blueshiftPDX/Helium/README.md

Helium
======

Helium supercapacitor-powered portable wireless speaker
