blueshiftPDX/Helium/hardware/helium_final_release_BOM.xls.xlsx

Sheet: main_1-5
BOM | Helium_main_1-6 | 2014-06-24
red | Do not install
yellow | changed part from v1.5
green | addition from v1.5
QTY | Reference | Part number | Manufacturer | Distributor No. | Description | Footprint | DNI? | link | NOTES
1 | U1 | BQ24640RVAR | TI | 296-27258-1-ND | supercapacitor charger IC | VQFN16 |  | http://www.digikey.com/product-detail/en/BQ24640RVAR/296-27258-1-ND/2270340
3 | P3, P4, P5 | B4B-PH-K-S(LF)(SN) | JST | 455-1706-ND | 4pin JST connector | H4_2mm |  | http://www.digikey.com/product-detail/en/B4B-PH-K-S(LF)(SN)/455-1706-ND/926613 | was side entry in 1.5 – now top entry, additional connector at P5. Mount so that slot faces board edge
2 | U5, U6 | MAX9759ETE+ | Maxim | MAX9759ETE+-ND | Mono Class-D Amp | TQFN16 |  | http://www.digikey.com/product-detail/en/MAX9759ETE%2B/MAX9759ETE%2B-ND/1495252
3 | SW3, SW2, P1 | 3-644456-2 | TE Connectivity | A31112-ND | Header open 2 pin .1” | SIL-2 |  | http://www.digikey.com/product-detail/en/3-644456-2/A31112-ND/698344
2 | Q3,Q2 | SIR426DP-T1-GE3 | Vishay | SIR426DP-T1-GE3CT-ND | Mosfet N-CH 40V | PowerPak SO-8 Single |  | http://www.digikey.com/product-detail/en/SIR426DP-T1-GE3/SIR426DP-T1-GE3CT-ND/2442130
0 | K1 | B03B-XASK-1(LF)(SN)(P) | JST | 455-1990-nd | Header shrouded 3 pin 2.5mm | SIL-3 | DNI |  | removed since v1.5
1 | U4 | Murata OKAMI 7805 | Murata | OKI-78SR-5/1.5-W36-C | Okami 7805 replacement TH | SIL-3 |  | http://www.digikey.com/product-detail/en/OKI-78SR-5%2F1.5-W36-C/811-2196-5-ND/2259781
1 | L1 | SRR1280-150M | Bourns Inc. | SRR1280-150MCT-ND | 15uH | SRR1280 inductor |  | http://www.digikey.com/product-detail/en/SRR1280-150M/SRR1280-150MCT-ND/2127431
4 | L2,L3,L4,L5 | SRR1280-330M | Bourns Inc. | SRR1280-330MCT-ND | 33uH | SRR1280 inductor |  | http://www.digikey.com/product-detail/en/SRR1280-330M/SRR1280-330MCT-ND/2127440
1 | U3 | TLV70245DBVT | TI | 296-30480-1-ND | 4.5V LDO | SOT23-5 |  | http://www.digikey.com/product-detail/en/TLV70245DBVT/296-30480-1-ND/3313487
1 | D2 | S10A-TP | Micro Commercial Co. | S10A-TPMSCT-ND | 10A diode | 2 pads .19” spacing |  | http://www.digikey.com/product-detail/en/S10A-TP/S10A-TPMSCT-ND/2041589
1 | F1 | 64900001039 | Littlefuse | WK0011-ND | fuse holder | http://media.digikey.com/pdf/Catalog%20Drawings/Circuit%20Protection/19649series-footprint.jpg |  | http://www.digikey.com/product-detail/en/64900001039/WK0011-ND/245470
1 | D1 | BAT54 | Fairchild Semi | BAT54FSCT-ND | BAT54 schottkey diode | SOT23-3 |  | http://www.digikey.com/product-detail/en/BAT54/BAT54FSCT-ND/458928
1 | R6 | WSL2010R0100FEA18 | Vishay | WSLF-.01CT-ND | .01 ohm sense resistor | SM2010 |  | http://www.digikey.com/product-detail/en/WSL2010R0100FEA18/WSLF-.01CT-ND/713450
3 | C4,C3,C19 | UMK316AB7475KL-T | Taiyo Yuden | 587-2994-1-ND | 4.7uF X7R | SM1206 |  | http://www.digikey.com/product-detail/en/UMK316AB7475KL-T/587-2994-1-ND/2714187
7 | C34,C27,C22,C23,C24,C12,C11 | GMK316BJ106KL-T | Taiyo Yuden | 587-2484-1-ND | 10uF X5R | SM1206 |  | http://www.digikey.com/product-detail/en/GMK316BJ106KL-T/587-2484-1-ND/2230350
1 | R18 | RC1206FR-0710RL | Yageo | 311-10.0FRCT-ND | 10 ohm 1/4W 1% film | SM1206 |  | http://www.digikey.com/product-detail/en/RC1206FR-0710RL/311-10.0FRCT-ND/731429
11 | R21,R19,R20,R29,R22,R24,R27,R13,R9,R7,R11 | RC0603FR-0710KL | Yageo | 311-10.0KHRCT-ND | RES 10.0K OHM 1/10W 1% | SM0603 |  | http://www.digikey.com/product-detail/en/RC0603FR-0710KL/311-10.0KHRCT-ND/729827
7 | C29,C13,C9,C10,C25,C26,C28 | C1608X7R1H104K080AA | TDK | 445-1314-1-ND | 0.1uF X7R | SM0603 |  | http://www.digikey.com/product-detail/en/C1608X7R1H104K080AA/445-1314-1-ND/567687
8 | C16,C14,C18,C21,C17,C1,C2,C15 | GMK107BJ105KA-T | Taiyo Yuden | 587-1437-1-ND | 1uF X7R | SM0603 |  | http://www.digikey.com/product-detail/en/GMK107BJ105KA-T/587-1437-1-ND/1004068
5 | R14,R12,R10,R8,R25 | MCR03ERTF4991 | Rohm Semi | RHM4.99KCFCT-ND | 5k 1% | SM0603 |  | http://www.digikey.com/product-detail/en/MCR03ERTF4991/RHM4.99KCFCT-ND/2796487
6 | R23,R5,R16,R15,R17,R30 | ERJ-3EKF4992V | panasonic | P49.9KHCT-ND | 50k 1% | SM0603 |  | http://www.digikey.com/product-detail/en/ERJ-3EKF4992V/P49.9KHCT-ND/198413
1 | R4 | RC0603FR-07487KL | Yageo | 311-487KHRCT-ND | 487k 1% | SM0603 |  | http://www.digikey.com/product-detail/en/RC0603FR-07487KL/311-487KHRCT-ND/730210 | different value from 1.5
1 | C5 | CL10C220JB8NNNC | Samsung | 1276-1023-1-ND | 22pF ceramic | SM0603 |  | http://www.digikey.com/product-detail/en/CL10C220JB8NNNC/1276-1023-1-ND/3889109
1 | R1 | ERJ-1TYJ2R0U | panasonic | PT2.0XCT-ND | 2 ohm 5% | SM2512 |  | http://www.digikey.com/product-detail/en/ERJ-1TYJ2R0U/PT2.0XCT-ND/365369
1 | J1 | JST_3-PIN_WITH_WIREOUTS | JST | PRT-09915 | 3pin JST connector 2mm | H3_2mm |  | https://www.sparkfun.com/products/9915 | moved slightly north from 1.5
4 | C36,C37,C39,C38 | ECQ-E2333KF | panasonic | EF2333-ND | 0.033µF TH polyester | cap_NP_7.5mm |  | http://www.digikey.com/product-detail/en/ECQ-E2333KF/EF2333-ND/56438
4 | C31,C33,C32,C30 | ECQ-V1154JM | panasonic | P4727-ND | .15uF TH polyester | cap_NP_9mm |  | http://www.digikey.com/product-detail/en/ECQ-V1154JM/P4727-ND/11530
3 | C8,C7,C6 | ECQ-V1H105JL | panasonic | P4675-ND | 1uF TH polyester | cap_NP_9mm |  | http://www.digikey.com/product-detail/en/ECQ-V1H105JL/P4675-ND/144391
2 | C41,C40 | ECQ-E2474KB | panasonic | P10975-ND | .47uF TH polyester | cap_NP_12.5mm |  | http://www.digikey.com/product-detail/en/ECQ-E2474KB/P10975-ND/295882
1 | U2 | BC127 | Bluecreation |  | BC127 Bluetooth module | 51 pin module |  | http://bluecreation.com/product_info.php?products_id=38 | shipping from Blue Creation (UK) (may have arrived 6/24?)
1 | SW1 | MMS42 | Apem Inc. | 679-1858-ND | 4PDT switch | DIL12 (2mm P x 2.5mm W) |  | http://www.digikey.com/product-detail/en/MMS42/679-1858-ND/1799368
4 | R2,R3,R26,R28 | DNP |  |  | extra resistor slots |  | DNI |  | Add 931K resistor at R2 for 15.9V limit; without this VCAP(max) = 23.9V
1 | JP1 | EG1218 | E-Switch | EG1903-ND | SPDT switch | SIL-3 |  | http://www.digikey.com/product-detail/en/EG1218/EG1903-ND/101726
1 | J2 | MOLEX_.1”_2pin | Molex | PRT-09918 | 2 pin molex vertical connector | SIL-2 |  | https://www.sparkfun.com/products/9918 | added since 1.5
1 | W1 | Automotive Jumper | Molex | PRT-09923 | Automotive Jumper 2-wire | SIL-3 |  | https://www.sparkfun.com/products/9923 | added since 1.5, replaces K1. Black to square pad, red to center pad. Connect smaller end (cpnnector B in datasheet) to MAIN board
1 | S1 | MCP130-475DI/TO | Microchip Technology | MCP130-475DI/TO-ND | IC SUPERVISOR 4.75V LOW TO92 | TO-92-3 |  | http://www.digikey.com/product-detail/en/MCP130-475DI%2FTO/MCP130-475DI%2FTO-ND/275234 | added since 1.5

Sheet: IND_0-7
 | INDICATOR | V0-7 | as built by Scott
Id | Designator | virtual part? | Package | Quantity | cost | Designation | Supplier and ref | exists in main board?
1 | Q1 |  | TO92DGS | 1 | 1 | MOSFET_P | http://www.digikey.com/product-detail/en/ZVP3306A/ZVP3306A-ND/92625
2 | GND V+ 5V PG | yes | SIL-4 | 1 | 0 | GND V+ 5V PG
3 | R2,R6 |  | R4 | 2 | 0.1 | 50k | http://www.digikey.com/product-detail/en/RNF14FTD49K9/RNF14FTD49K9CT-ND/1975142
4 | R1,R4,R7 |  | R4 | 3 | ,05 | 3.9k | http://www.digikey.com/product-detail/en/RNF14FTD3K92/RNF14FTD3K92CT-ND/1975058
5 | R5,R3 |  | R4 | 2 | ,05 | 2.2k | http://www.digikey.com/product-detail/en/RNF14FTD2K21/RNF14FTD2K21CT-ND/1975041
6 | BAR1 |  | DIP-20__300 | 1 | 1.56 | DOT-BAR2 | http://www.digikey.com/product-detail/en/LTA-1000G/160-1067-ND/153278 |  | https://www.sparkfun.com/products/9937
7 | U1 |  | DIP-18__300 | 1 | 1 | LM3914 | http://www.digikey.com/product-detail/en/LM3914N-1%2FNOPB/LM3914N-1%2FNOPB-ND/334820
8 | C1 |  | C2 | 0 |  | 1uF | http://www.digikey.com/product-detail/en/ECQ-V1H105JL/P4675-ND/144391 | yes
 |  |  |  |  | 3.66

Sheet: cap bank
PART # | manufacturer | QTY mono | QTY stereo
BCAP0350 | Maxwell | 6 | 9
10k ohm 1% resistor |  | 6 | 9
Fuse holder |  | 1
5A slow fuse |  | 1
