blueshiftPDX/Helium/hardware/helium_1-6.kicad_pcb

## KiCad design hardware/helium_1-6.kicad_pcb (2016-01-26)

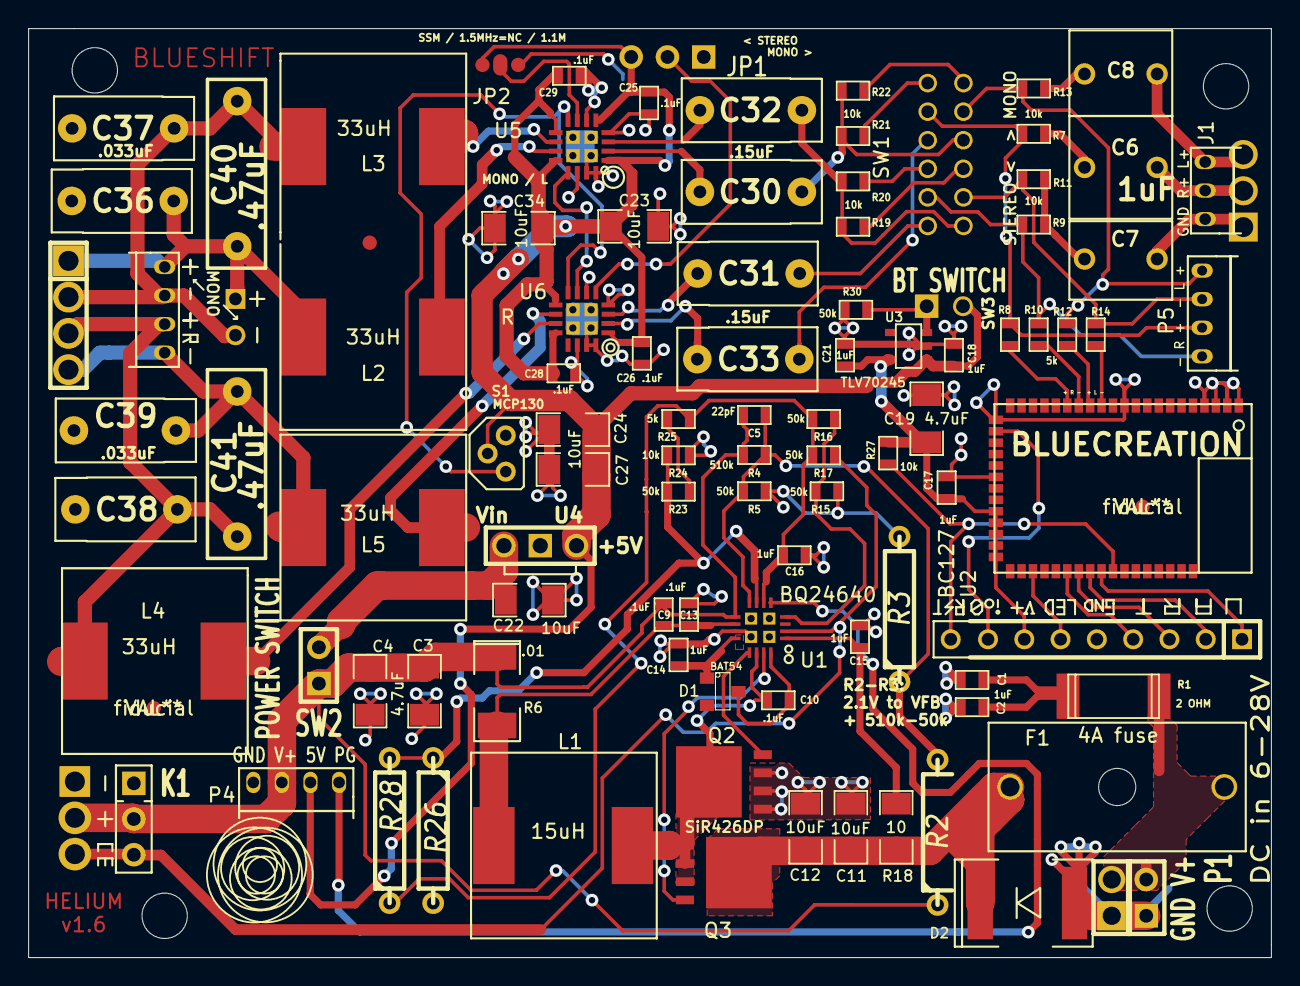
[picture p1: board helium_1-6.kicad_pcb from above]

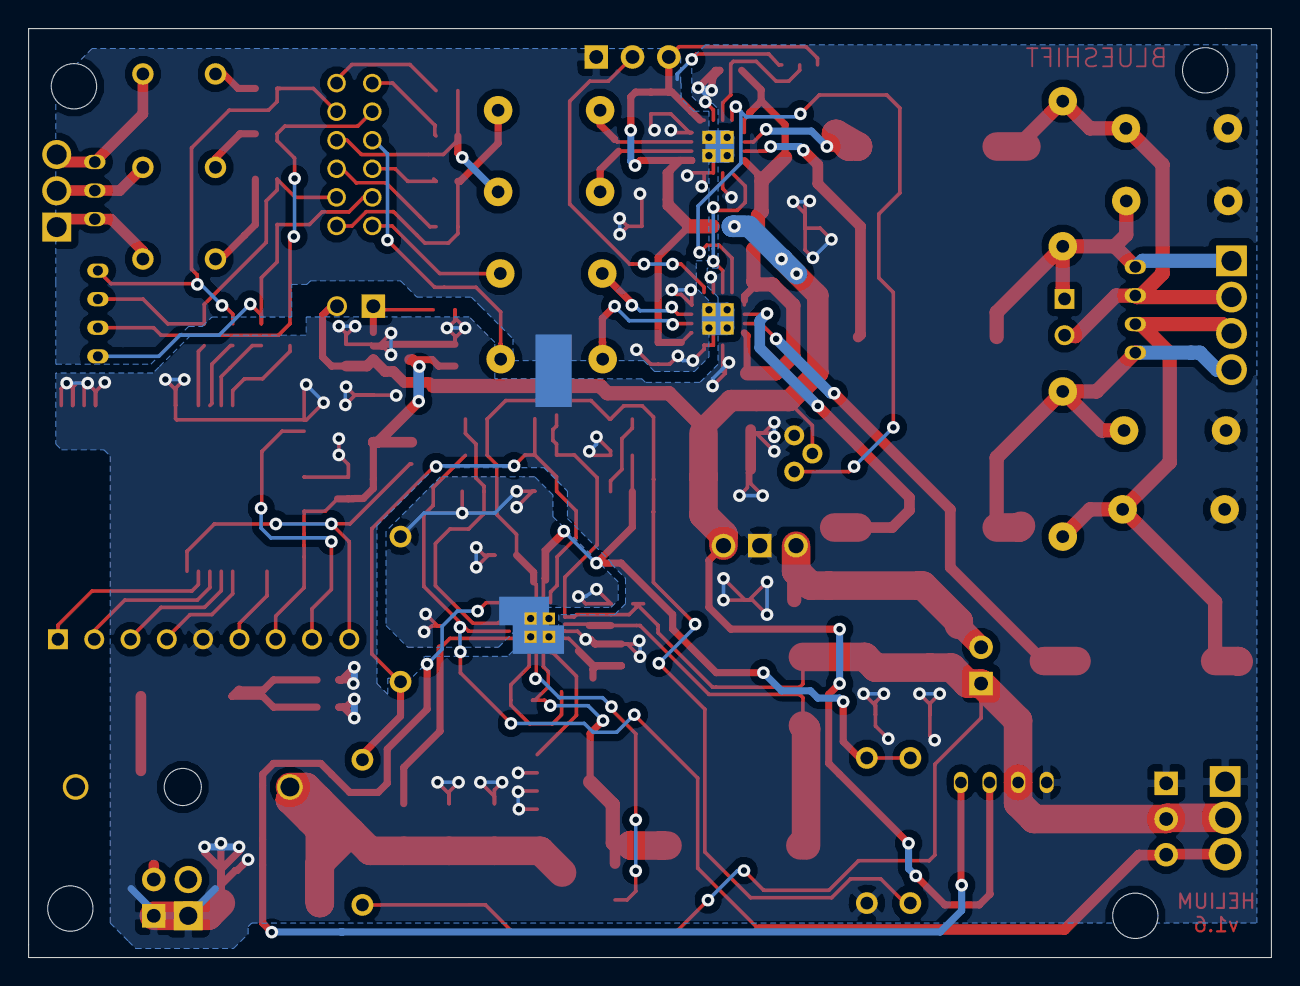
[picture p2: board helium_1-6.kicad_pcb from below]

Board: 2 copper layers, 87.0 x 65.0 mm, 112 parts (2 on the bottom side), 69 nets.

Parts:
C1, C2, C14, C15, C16, C17, C18, C21: 1uF; SM0603
C3, C4, C19: 4.7uF; SM1206
C5: 22pF; SM0603
C6, C7, C8: 1uF; cnp_7mm_035holes
C9, C10, C13, C25, C26, C28, C29: .1uF; SM0603
C11, C12, C22, C23, C24, C27, C34: 10uF; SM1206
C30, C31, C32, C33: .15uF; cnp_10x4.5mm
C36, C37, C38, C39: .033uF; cnp_10x4.5mm
C40, C41: .47uF; cnp_13x4mm
D1: BAT54; SOT23
D2: 10A diode; SM2010
F1: 4A fuse; fuse
J1: GND R+ L+; h3_2mm
JP1: < STEREO; SIL-3
JP2: SSM / 1.5MHz=NC / 1.1M; jump
K1: TO SUPERCAPS: GND / V+ / CE; SIL-4
L1: 15uH; SRR1280 inductor
L2: 33uH; SRR1280_ind_outline
L3, L4, L5: 33uH; SRR1280 inductor
P1: GND V+; SIL-2
P2: 4xUART/GND/LED/V+/IO; SIL-8-outputs
P3, P5: CONN_4; h4_2mm
P4: GND V+ 5V PG; h4_2mm
Q2, Q3: SiR426DP; PowerPak SO-8 Single
R1: 2 OHM; r_2512
R2: 931k MONO ONLY; R4
R3, R26, R28: DNP; R4
R4: 510k; SM0603
R5, R15, R16, R17, R23, R30: 50k; SM0603
R6: .01; SM2010
R7, R9, R11, R13, R19, R20, R21, R22, R24, R27: 10k; SM0603
R8, R10, R12, R14, R25: 5k; SM0603
R18: 10; SM1206
S1: MCP130; TO92PN
SIL-2, SIL-2#2: Val**; SIL-2
SIL-3, SIL-3#2: Val**; SIL-3
SIL-4: Val**; SIL-4
SW1: STEREO < > MONO; 4PDT MMS42R
SW2: POWER SWITCH; SIL-2
SW3: BT SWITCH; SIL-2
U1: BQ24640; BQ24640 QFN16
U2: BC127; bC127
U3: TLV70245; SOT23-5
U4: U4; SIL-3
U5: MONO / L; max9759
U6: R; max9759
XXX1, XXX3: SHORT!
fiducial: VAL**; fiducial
fiducial#2, fiducial#3: VAL**; fiducial
hole: Val**; hole
hole#2, hole#3, hole#4: Val**; hole
xxx2: short; SHORT!

Connections:
CAPGND: C1.2, C2.2, C3.2, C4.2, C11.2, C12.2, C14.2, C17.2, C18.2, C19.2, C21.2, C22.2, C24.2, C27.2, C28.2, C29.2, C34.2, C36.2, C37.1, C38.2, C39.1, D2.1, K1.1, P1.2, P2.5, P4.1, Q2.1, Q2.2, Q2.3, R24.2, R26.2, R30.2, S1.3, SIL-2#2.2, SIL-3.1, U1.11, U2.1, U2.2, U2.3, U2.4, U2.11, U2.22, U2.27, U3.2, U4.2, U5.6, U5.14, U6.6, U6.14, XXX1.2, xxx2.1
CAPV+: C3.1, C4.1, C5.1, C9.2, K1.2, P4.2, R2.1, R4.1, R6.1, SIL-3.2, SW2.1, U1.9
CE: K1.3, R17.2, SIL-3.3, U1.2
GNDA: C13.2, C15.2, C16.2, C23.2, C25.2, C26.2, JP1.1, JP2.3, R3.2, R5.2, R15.2, U5.4, U5.15, U5.16, U6.4, U6.15, U6.16, XXX1.1, xxx2.2
unnamed: JP1.2, U6.5
unnamed: P2.1, U2.43
unnamed: R22.1, SW1.12
unnamed: P5.1, R9.2, R10.1, SW1.2
unnamed: P5.2, R7.2, R8.1, SW1.5
unnamed: R21.1, SW1.6
unnamed: P5.3, R11.2, R14.1, SW1.8
unnamed: R20.1, SW1.3
unnamed: R19.1, SW1.9
unnamed: R10.2, U2.15
unnamed: P2.2, U2.42
unnamed: P2.3, U2.41
unnamed: P2.4, U2.40
unnamed: P2.9, R27.1, U2.44
unnamed: R14.2, U2.13
unnamed: C6.1, J1.2, SIL-3#2.2
unnamed: R12.2, U2.14
unnamed: R8.2, U2.16
unnamed: P5.4, R12.1, R13.2, SW1.11
unnamed: C30.1, U5.2
unnamed: C32.1, U5.3
unnamed: C31.2, U6.3
unnamed: C33.2, U6.2
unnamed: C5.2, R2.2, R3.1, R4.2, R5.1, U1.8
unnamed: C10.2, D1.2, U1.16
unnamed: C14.1, D1.1, U1.12
unnamed: R15.1, R16.2, U1.4
unnamed: L2.1, U5.11
unnamed: L5.1, U6.10
unnamed: L4.1, U6.11
unnamed: U5.13, U6.7
unnamed: C22.1, SW2.2, U4.3
unnamed: C8.1, J1.3, SIL-3#2.3
unnamed: R23.1, R25.2
unnamed: R23.2, R24.1, R26.1, R28.2, U1.7
unnamed: C31.1, SW1.1
unnamed: F1.1, P1.1, R1.1, SIL-2#2.1
unnamed: P4.4, U1.5
unnamed: C7.2, R9.1, R11.1
unnamed: C7.1, J1.1, SIL-3#2.1
unnamed: C8.2, R13.1
unnamed: L3.1, U5.10
unnamed: C32.2, R19.2, R20.2, SW1.7
unnamed: C30.2, R21.2, R22.2, SW1.10
unnamed: C33.1, SW1.4
unnamed: C6.2, R7.1
unnamed: P2.6, U2.37
unnamed: P2.8, U2.23
unnamed: JP2.2, U5.7
unnamed: C23.1, C25.1, C26.1, JP1.3, JP2.1, S1.1, U5.1, U5.5, U5.8, U6.1, U6.8, XXX3.2
unnamed: C11.1, C12.1, D2.2, F1.2, Q3.5, Q3.6, Q3.7, Q3.8, R18.1
unnamed: C10.1, L1.1, Q2.5, Q2.6, Q2.7, Q2.8, Q3.1, Q3.2, Q3.3, U1.14
unnamed: Q3.4, U1.15
unnamed: C16.1, R16.1, R17.1, R25.1, R28.1, U1.6
unnamed: Q2.4, U1.13
unnamed: C1.1, C2.1, R1.2
unnamed: C15.1, R18.2, U1.1
unnamed: C18.1, C24.1, C27.1, C28.1, C29.1, C34.1, P4.3, S1.2, SW3.2, U3.1, U4.1, U5.9, U5.12, U6.9, U6.12, XXX3.1
unnamed: C36.1, C40.1, L2.2, P3.1, SIL-2.1, SIL-4.1
unnamed: C37.2, C40.2, L3.2, P3.2, SIL-2.2, SIL-4.2
unnamed: C9.1, C13.1, L1.2, R6.2, U1.10
unnamed: R30.1, SW3.1, U3.3
unnamed: C17.1, C19.1, C21.1, P2.7, R27.2, U2.30, U2.31, U2.32, U2.33, U2.34, U3.5
unnamed: C38.1, C41.1, L4.2, P3.3, SIL-4.3
unnamed: C39.2, C41.2, L5.2, P3.4, SIL-4.4
